Bianca66/infusion_pump/Menu_Characters.h

// Creates 3 custom characters for the menu display
byte downArrow[8] = {
  B00100, //   *
  B00100, //   *
  B00100, //   *
  B00100, //   *
  B00100, //   *
  B10101, // * * *
  B01110, //  ***
  B00100  //   *
};

byte upArrow[8] = {
  B00100, //   *
  B01110, //  ***
  B10101, // * * *
  B00100, //   *
  B00100, //   *
  B00100, //   *
  B00100, //   *
  B00100  //   *
};

byte menuCursor[8] = {
  B01000, //  *
  B00100, //   *
  B00010, //    *
  B00001, //     *
  B00010, //    *
  B00100, //   *
  B01000, //  *
  B00000  //
};

byte menuSyringe[8] = {
  B11111, // ******
  B00000, // 
  B00000, //
  B00000, //
  B00000, //
  B00000, //
  B11111, // *****
  B00000  // 
};

byte menuFill[8] = {
  B11111, // *****
  B00000, //
  B11111, // *****
  B11111, // *****
  B11111, // *****
  B00000, // 
  B11111, // *****
  B00000  // 
};
